HexabitzPlatform/H12R0x-Hardware/README.md

# H12R0x-Hardware
Hexabitz Industrial 12-Bit Analog Input ±10 V Module Hardware Design
