HexabitzPlatform/H12R0x-Hardware/H12R00/Released/BOM/H12R00.xlsx

 |  | www.hexabitz.com info@hexabitz.com |  | Bill Of Materials
Customer | Hexabitz | Revision | 0
Project | Hexabitz Modules | Date | 2023-10-30
Board | Industrial Analog I/P ±10 V (H12R00) | Notes
Designator | Description | Manufacturer Part Number | Manufacturer | Octopart Url | Quantity
RESET | Headers & Wire Housings Unshrouded 1 POS T/H | 5-146280-1 | TE Connectivity | https://octopart.com/5-146280-1-te+connectivity+%2F+amp-40259676?r=sp | 1
SWD | Conn Unshrouded Header HDR 3 POS 2.54mm Solder ST Top Entry Thru-Hole Carton | 5-146281-3 | TE Connectivity | https://octopart.com/5-146281-3-te+connectivity+%2F+amp-39745942?r=sp | 1
J1 | 5pin Terminal Block; Printed Circuit; 10 A; 160 V; 3.5 mm; 5; 3.5 mm; 1.2 mm; M2; PA | 1984646 | Phoenix Contact | https://octopart.com/1984646-phoenix+contact-50274?r=sp&s=drI_GVM4QHaL48lSCATrxQ | 1
R1 | RES SMD 0.0OHM JUMPER 1/10W 0603 | RC0603JR-070RL | YAGEO [VR] | https://octopart.com/rc0603jr-070rl-yageo-1241539?r=sp | 1
R6 | RES 49,9 Ohms1% 1/10w 0603 | 0603WAF499JT5E | ROYAL OHM | https://octopart.com/0603waf499jt5e-royal+ohm-50590453?r=sp | 1
R2 | Thick Film Resistors - SMD 0603 270 Ohm 5% Tol | ERJ-3GEYJ271V | Panasonic | https://octopart.com/erj-3geyj271v-panasonic-55560546?r=sp | 1
R4 | Thick Film Resistors - SMD 4.99 kOhms 100mW 0603 1% | RC0603FR-074K99L | YAGEO [VA] | https://octopart.com/rc0603fr-074k99l-yageo-55458490?r=sp | 1
R3,R5 | RES SMD 10K OHM 1% 1/10W 0603 | RC0603FR-0710KL | YAGEO | https://octopart.com/rc0603fr-0710kl-yageo-40025538?r=sp | 2
R7 | Res Thick Film 0603 150K Ohm 1% 1/10W ±100ppm/°C Molded SMD Paper T/R | CRCW0603150KFKEA | Vishay | https://octopart.com/crcw0603150kfkea-vishay-39455816?r=sp | 1
C19, C20 | CAP CER 100PF 50V C0G/NP0 0603 | C0603C101J5GACTU | KEMEET | https://octopart.com/c0603c101j5gactu-kemet-100052?r=sp | 2
C8 | CAP Ceramic 0,015UF 25V 5% Pad SMD | C0603C153J3GACTU | VENDOR KEMET | https://octopart.com/c0603c153j3gactu-kemet-12793174?r=sp | 1
C9 | CAP CER 0.033UF 16V X7R 0603 | C0603C333K4RACTU | KEMET [VA] | https://octopart.com/c0603c333k4ractu-kemet-9143755?r=sp | 1
C1, C2, C4, C6, C14, C15, C16, C18 | CAP CER 0.1 UF 10V 10% X7R 0603 | C0603C104K8RACTU | KEMET | https://octopart.com/c0603c104k8ractu-kemet-145075?r=sp&s=9bS9ASSwSEqMCE9KBEQZ0g | 8
C12, C13, | CAP CER 0.1UF 50V X7R 0603 | C1608X7R1H104K080AA | TDK Corporation | https://octopart.com/c1608x7r1h104k080aa-tdk-25947665?r=sp | 2
C5 | CAP CER 1 UF 16V X7R 0805 | CC0805KKX7R7BB105 | YAGEO [VA] | https://octopart.com/cc0805kkx7r7bb105-yageo-8376555?r=sp | 1
C3, C7, C17 | CAP TANT 4.7 UF 10V 20% 0805 | 10TPU4R7MSI | Panasonic | https://octopart.com/10tpu4r7msi-panasonic-29487748?r=sp | 3
C10 , C11 | Multilayer Ceramic Capacitors MLCC - SMD/SMT 10 uF 35 VDC 20% 0805 X5R | GRM21BR6YA106ME43K | Murata Electronics | https://octopart.com/grm21br6ya106me43k-murata-57368791?r=sp | 2
FB1 | Ind chip Bead Multi-Layer 30 ohms 25% 100MHZ Ferrite 1,5A 0603Punched paper T/R | MMZ1608Y300BTA00 | TDK | https://octopart.com/mmz1608y300bta00-tdk-7906990?r=sp | 1
D1 | Red 0603 130° Clear 54 mcd 2 V Surface Mount ChipLED | VLMS1300-GS08 | Vishay | https://octopart.com/vlms1300-gs08-vishay-21709201?r=sp&s=0nXJNjGsSbWwqfqWlZv0EA | 1
TVS1, TVS2 | Diode TVS Single Bi-Dir 17V 600W 2-Pin SMB | SMBJ17CA | Bourns | https://octopart.com/smbj17ca-bourns-12809460?r=sp | 2
TVS3 | TVS DIODE 3,3V 10,9V SOD323 | CDSOD323-T03SC | BOURNS INC | https://octopart.com/cdsod323-t03sc-bourns-10487153?r=sp | 1
U1 | MCU 32-Bit ARM Cortex-M0+ RISC 512kByte Flash 1.7V to 3.6V 48-Pin UFQFPN Tray | STM32G0B1CEU6N | STMicroelectronics | https://octopart.com/stm32g0b1ceu6n-stmicroelectronics-116364672?r=sp | 1
U2 | Instrument Amplifier, 1, 50 V, 1.2 V/ S, 1 Mhz, 2.3V To 18V | AD628ARZ | Analog Devices | https://octopart.com/ad628arz-analog+devices-410882?r=sp | 1
U3 | 3-V Vref, low-drift, low-power, dual-output Vref & Vref/2 voltage reference 5-SOT-23-THIN -40 to 125 | REF2030AIDDCT | Texas Instruments | https://octopart.com/ref2030aiddct-texas+instruments-46921198?r=sp | 1
X1 | 8,0000MHZ 33pF SMD MURATA Resonators | CSTNE8M00G550000R0 | Murata | https://octopart.com/cstne8m00g550000r0-murata-91406934?r=sp | 1
