HexabitzPlatform/H12R0x-Hardware/H12R00/Documentation/H12R00.pdf

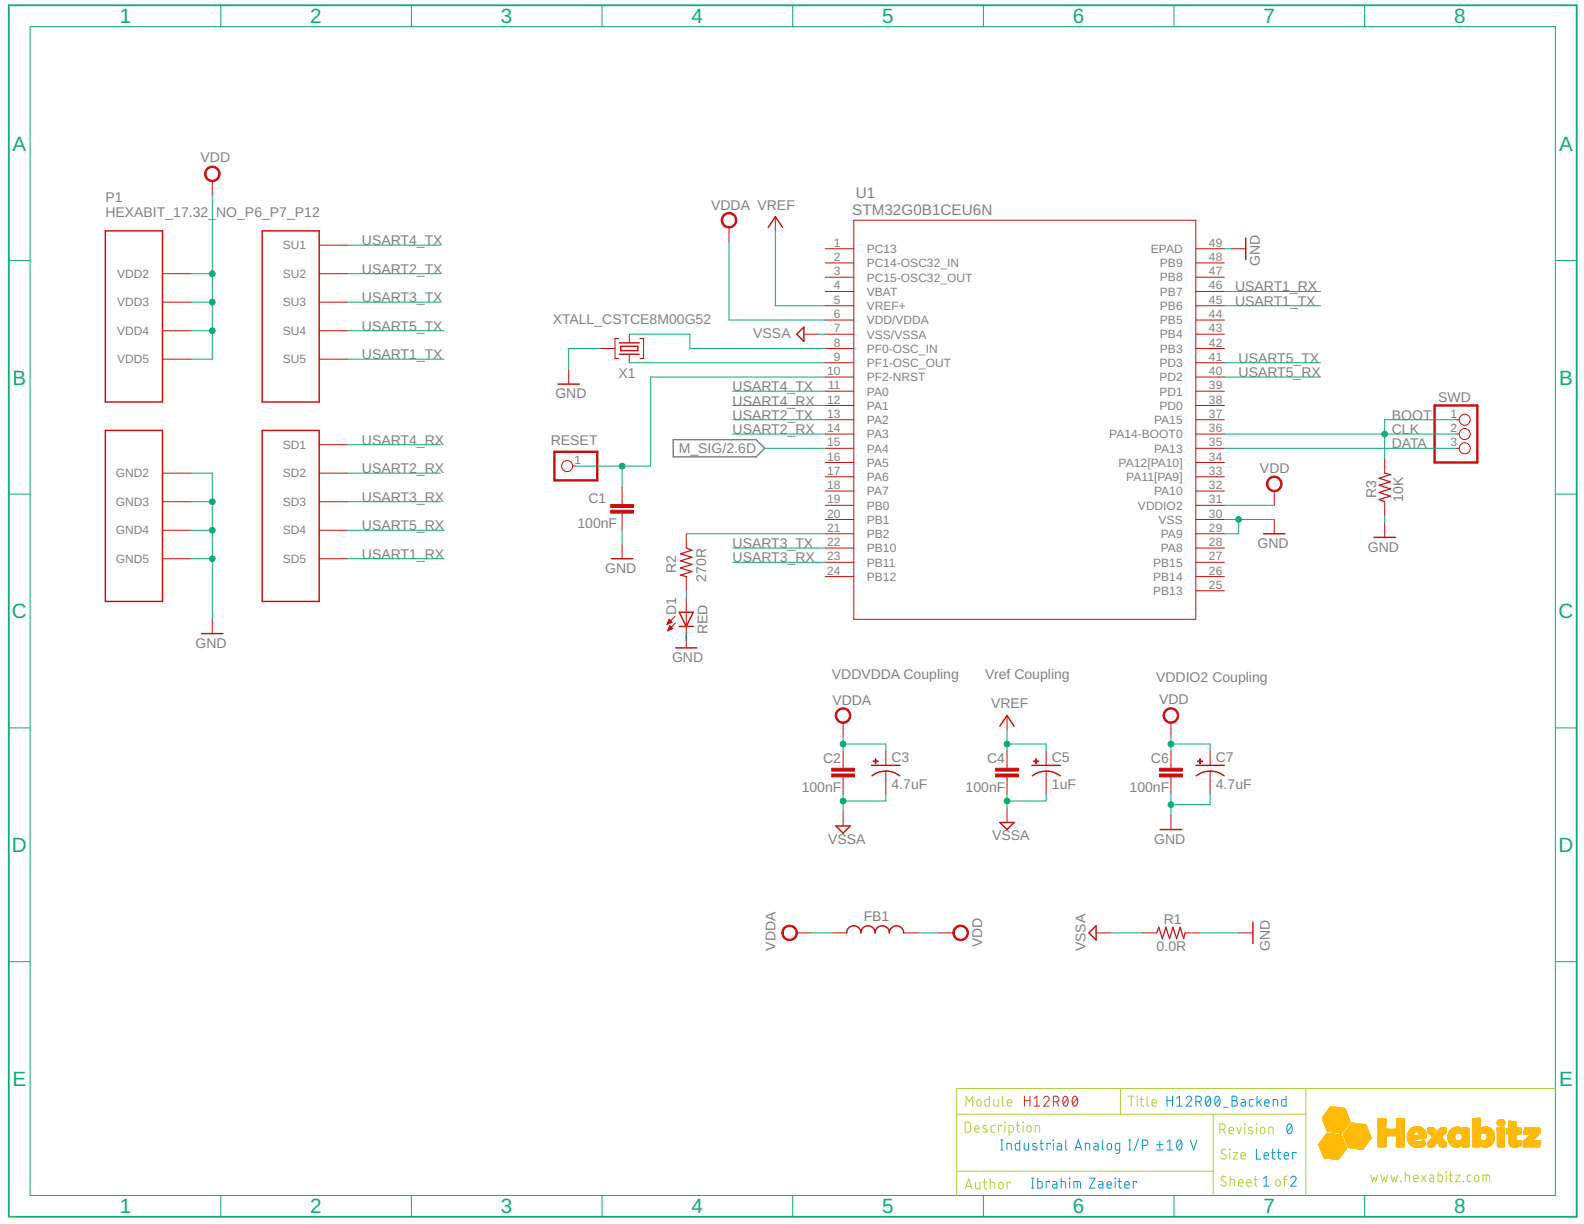
[picture p1: page 1]

35 PA14-BOOT0 | DATA
32 PA11[PA9] 33 PA12[PA10] 34 PA13

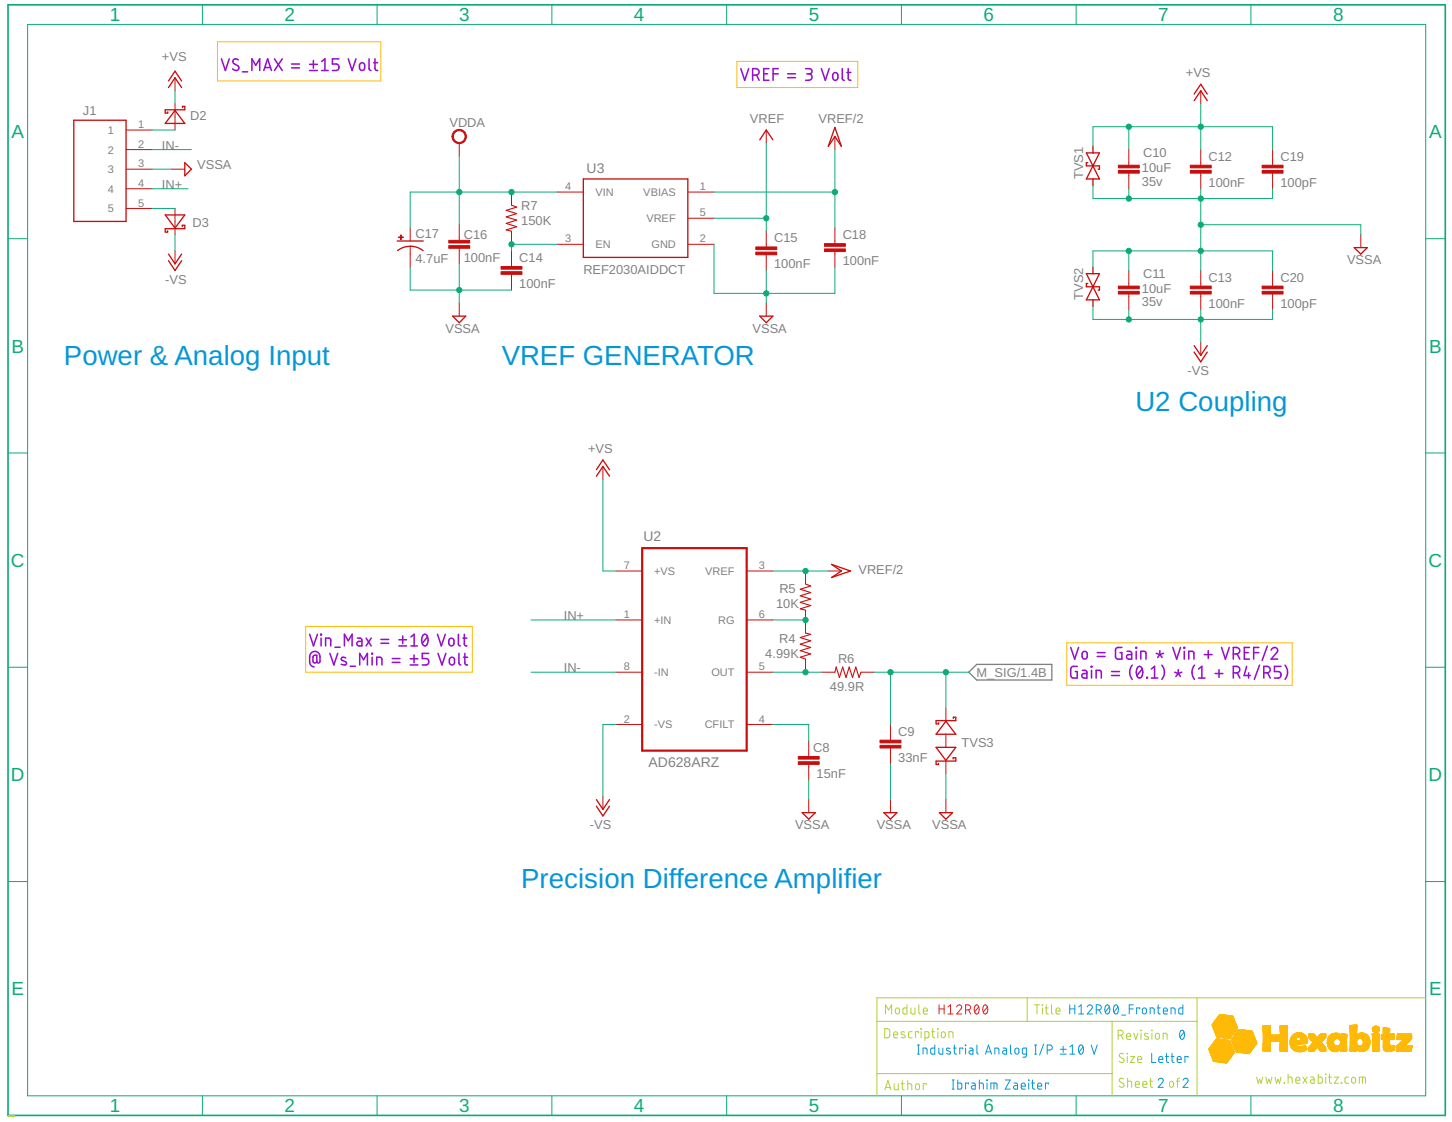
[picture p2: page 2]
