HexabitzPlatform/H12R0x-Hardware/H12R00/Design/H12R00.brd

## EAGLE design H12R00/Design/H12R00.brd (2023-11-05)

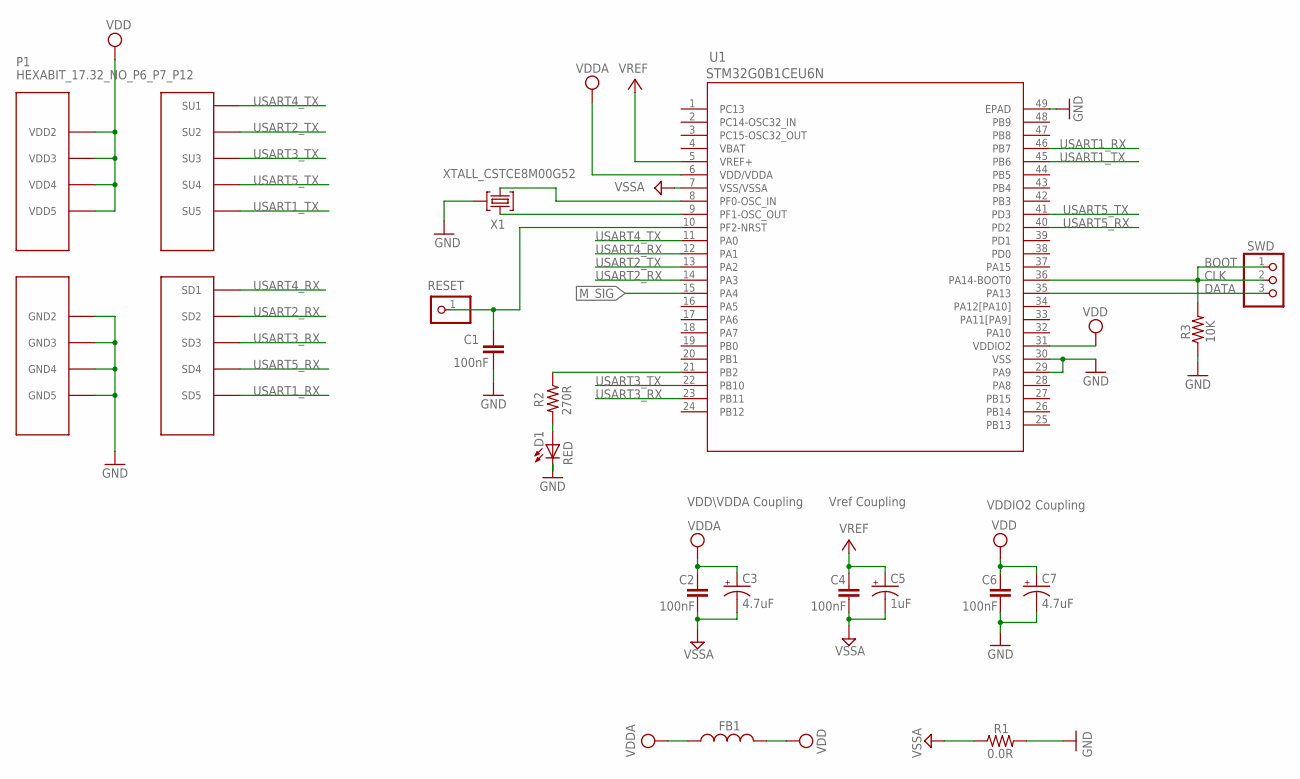
[picture p3: schematic H12R00.sch, sheet 1]

Parts:
C1, C2, C4, C6: 100nF; C-0603
C3, C7: 4.7uF; C-0805-POL
C5: 1uF; C-0805-POL
D1: RED; VLMS1300-GS08; MPN VLMS1300-GS08
FB1: FB-0603
P1: HEXABIT_17.32_NO_P6_P7_P12
R1: 0.0R; R-0603
R2: 270R; R-0603
R3: 10K; R-0603
RESET: R; 1X01
SWD: PINHD-1X3SWD; SWD
U1: STM32G0B1CEU6N; HEXABITZ_ICS_QFN_B1CEU6_STM-L
X1: XTALL_CSTCE8M00G52

Connections:
CLK: R3.2, SWD.1, SWD.2, U1.36 (PA14-BOOT0)
DATA: SWD.3, U1.35 (PA13)
GND: C1.2, C6.2, C7.2 (-), D1.C, P1.PAD_PD8 (GND2), P1.PAD_PD9 (GND3), P1.PAD_PD10 (GND4), P1.PAD_PD11 (GND5), R1.2, R3.1, U1.29 (PA9), U1.30 (VSS), U1.49 (EPAD), X1.P$2 (2)
M_SIG: U1.15 (PA4); also elsewhere on the board
unnamed: D1.A, R2.2
unnamed: R2.1, U1.21 (PB2)
unnamed: U1.9 (PF1-OSC_OUT), X1.P$1 (1)
unnamed: U1.8 (PF0-OSC_IN), X1.P$3 (3)
unnamed: C1.1, RESET.1, U1.10 (PF2-NRST)
USART1_RX: P1.PAD_PD5 (SD5), U1.46 (PB7)
USART1_TX: P1.PAD_PU5 (SU5), U1.45 (PB6)
USART2_RX: P1.PAD_PD2 (SD2), U1.14 (PA3)
USART2_TX: P1.PAD_PU2 (SU2), U1.13 (PA2)
USART3_RX: P1.PAD_PD3 (SD3), U1.23 (PB11)
USART3_TX: P1.PAD_PU3 (SU3), U1.22 (PB10)
USART4_RX: P1.PAD_PD1 (SD1), U1.12 (PA1)
USART4_TX: P1.PAD_PU1 (SU1), U1.11 (PA0)
USART5_RX: P1.PAD_PD4 (SD4), U1.40 (PD2)
USART5_TX: P1.PAD_PU4 (SU4), U1.41 (PD3)
VBAT: U1.4 (VBAT)
VDD: C6.1, C7.1 (+), FB1.2, P1.PAD_PU8 (VDD2), P1.PAD_PU9 (VDD3), P1.PAD_PU10 (VDD4), P1.PAD_PU11 (VDD5), U1.31 (VDDIO2)
VDDA: C2.1, C3.1 (+), FB1.1, U1.6 (VDD/VDDA); also elsewhere on the board
VREF: C4.1, C5.1 (+), U1.5 (VREF+); also elsewhere on the board
VSSA: C2.2, C3.2 (-), C4.2, C5.2 (-), R1.1, U1.7 (VSS/VSSA); also elsewhere on the board

Notes on the sheet:
Vref Coupling
VDDIO2 Coupling
VDD\VDDA Coupling
BOOT

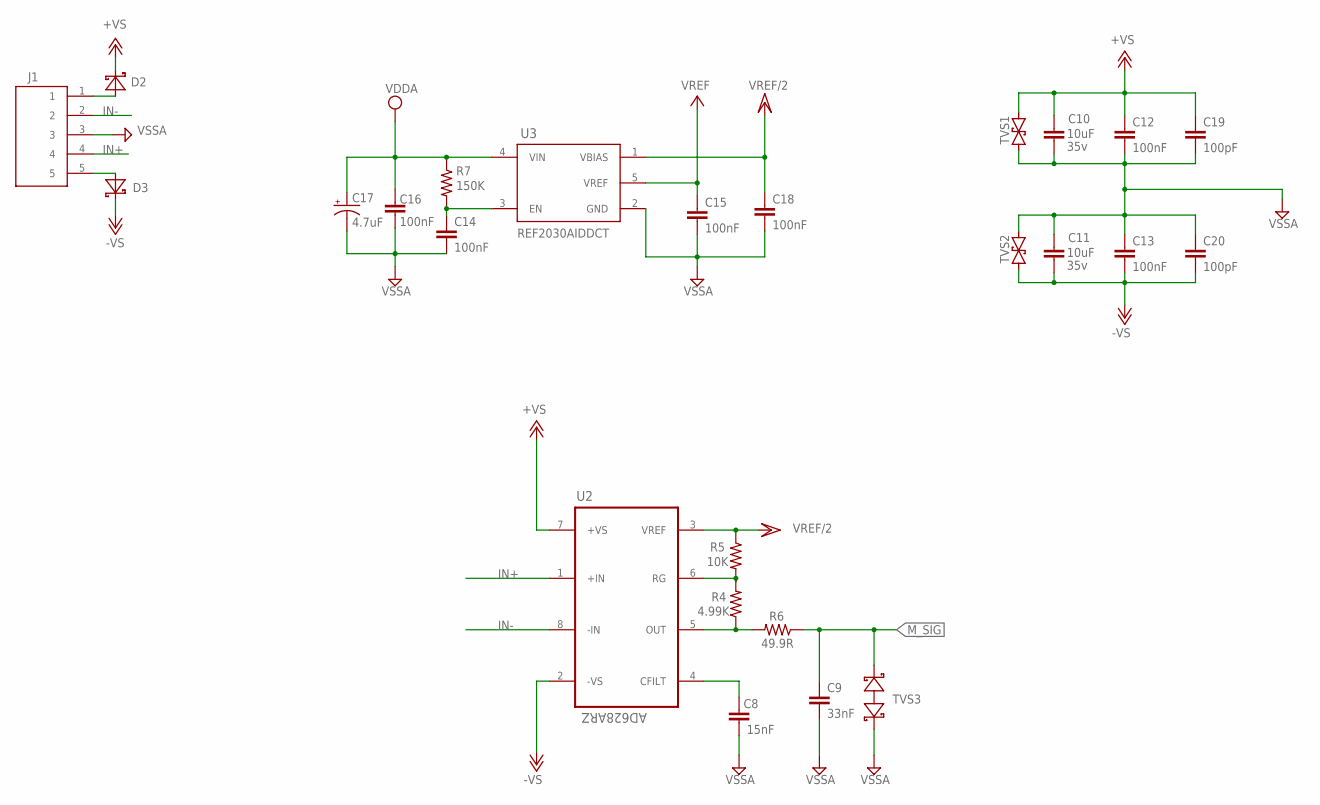
[picture p4: schematic H12R00.sch, sheet 2]

Parts:
C8: 15nF; C-0603
C9: 33nF; C-0603
C10, C11: C-0805; VOLTAGE_RATING 35v; MPN GRM21BR6YA106ME43K
C12, C13: 100nF; C-0603; MPN C1608X7R1H104K080AA
C14, C15, C16, C18: 100nF; C-0603
C17: 4.7uF; C-0805-POL
C19, C20: 100pF; C-0603; MPN C1608X7R1H104K080AA
D2, D3: DIOD-SOD-123; SOD123
J1: 1984646
R4: 4.99K; R-0603
R5: 10K; R-0603
R6: 49.9R; R-0603
R7: 150K; R-0603
TVS1, TVS2: SMBJ30CA; DO214AA
TVS3: BOURNS_CDSOD323-T03SCBOURNS_CDSOD323-T03SC_0_0; BOURNS_CDSOD323-T03SC_0
U2: AD628ARZ; SOIC127P600X175-8N
U3: TEXAS_INSTRUMENTS_REF2033AIDDCRTEXAS_INSTRUMENTS_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; TEXAS_INSTRUMENTS_REF2033AIDDCR_2; MPN REF2030AIDDCT

Connections:
+VS: C10.1, C12.1, C19.1, D2.2 (C), TVS1.C (2), U2.7 (+VS)
-VS: C11.2, C13.2, C20.2, D3.2 (C), TVS2.A (1), U2.2 (-VS)
CFILT: C8.1, U2.4 (CFILT)
IN+: J1.4, U2.1 (+IN)
IN-: J1.2, U2.8 (-IN)
M_SIG: C9.1, R6.1, TVS3.2 (C); also elsewhere on the board
unnamed: D3.1 (A), J1.5
unnamed: D2.1 (A), J1.1
unnamed: C14.1, R7.2, U3.3 (EN)
OUT: R4.1, R6.2, U2.5 (OUT)
RG: R4.2, R5.2, U2.6 (RG)
VDDA: C16.1, C17.1 (+), R7.1, U3.4 (VIN); also elsewhere on the board
VREF: C15.1, U3.5 (VREF); also elsewhere on the board
VREF/2: C18.1, R5.1, U2.3 (VREF), U3.1 (VBIAS)
VSSA: C8.2, C9.2, C10.2, C11.1, C12.2, C13.1, C14.2, C15.2, C16.2, C17.2 (-), C18.2, C19.2, C20.1, J1.3, TVS1.A (1), TVS2.C (2), TVS3.1 (A), U3.2 (GND); also elsewhere on the board

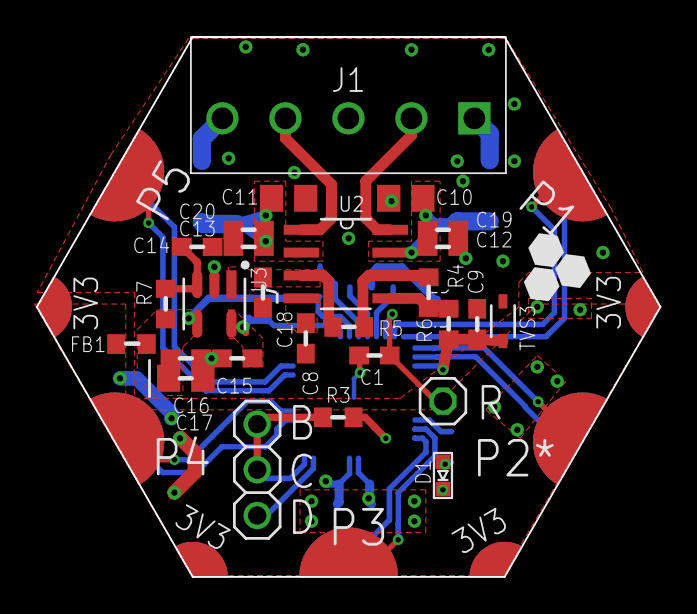
[picture p5: board H12R00.brd from above]

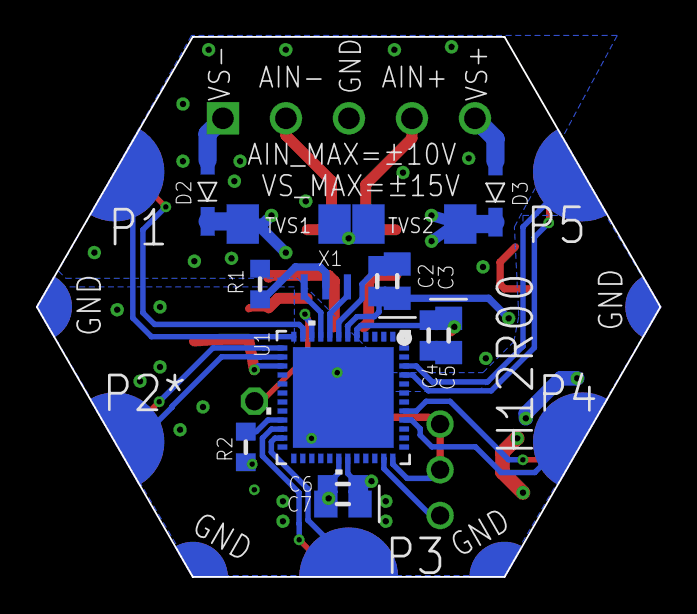
[picture p6: board H12R00.brd from below]

Board: 2 copper layers, 34.6 x 30.0 mm, 42 parts (14 on the bottom side), 34 nets.
