HexabitzPlatform/H12R0x-Hardware/(commit log)

2020-03-16 Adding template files
    [H12R00.brd, H12R00.sch]
2020-03-16 in this commit:
    - schematic is ready
    - PCB is ready
    - All output files were generated
    [H12R00.brd, H12R00.sch, H12R00.xlsx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]
2020-03-18 - replaced connectors and redrawn PCB (output files were not updated)
2020-03-18 minor modifications on res names placements
    [H12R00.brd]
2020-03-29 changed schematic design and modifies PCB (output files were not updated)
    [H12R00.brd, H12R00.sch]
2020-04-07 PCB modifications and output files were generated
    [H12R00.brd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]
2020-04-24 Update some components from lib. REF is missing in lib
    [H12R00.brd, H12R00.sch]
2020-04-25 Update REF from library Fix routing and DRC issues
    [H12R00.brd, H12R00.sch]
2020-04-25 Review ERC/DRC Generate gerber, drill, schematics pdf and pick n place Update BOM Release V0
    [H12R00.xlsx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]
2020-05-23 Fix some BOM errors
    [H12R00.xlsx]
2020-12-28 - Fixed C11 and C14 attributes..
    [H12R00.brd, H12R00.sch]
2021-09-06 - Fixed labels in .sch and .brd from 12v to 10v - Regenerated docoument file - Fixed BOM - Regenerated output files (Gerber, drills, mount)
    [H12R00.brd, H12R00.sch, H12R00.xlsx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]
2021-09-24 - Made some Hardware modifications (.sch and .brd where updated) - Updated Documentation - Updated BOM - Regenerated output files
    [H12R00.brd, H12R00.sch, H12R00.xlsx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]
2023-10-29 -First commit after the mass editing (before start wiring) : 1- Edit the design so the module can measure the pos & neg sides of the analog input signal . 2 - Change the MCU to stm32g0b1ceu6n
    [copper_bottom.gbr, copper_top.gbr, drill_1_16.xln, gerber_job.gbrjob, profile.gbr, silkscreen_bottom.gbr, silkscreen_top.gbr, soldermask_bottom.gbr]
2023-10-29 -After wiring
    [H12R00.brd, H12R00.sch]
2023-10-30 -All done
    [H12R00.brd, H12R00.sch, H12R00.xlsx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]
2023-11-05 - Fix some documentation issues
    [H12R00.brd, H12R00.xlsx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]
2023-11-05 -Fix BOM
    [H12R00.xlsx]
